Jcarbonell04/RGB-Reader/_datasheets/README.md

# Relevant Datasheets

Use this folder to store all relevant datasheets for devices used in your project.
