Jcarbonell04/RGB-Reader/pcb/README.md

# PCB Design

All design files for your PCB version of your project go here.
