Jcarbonell04/RGB-Reader/pcb/Choosing PWM Channels.png

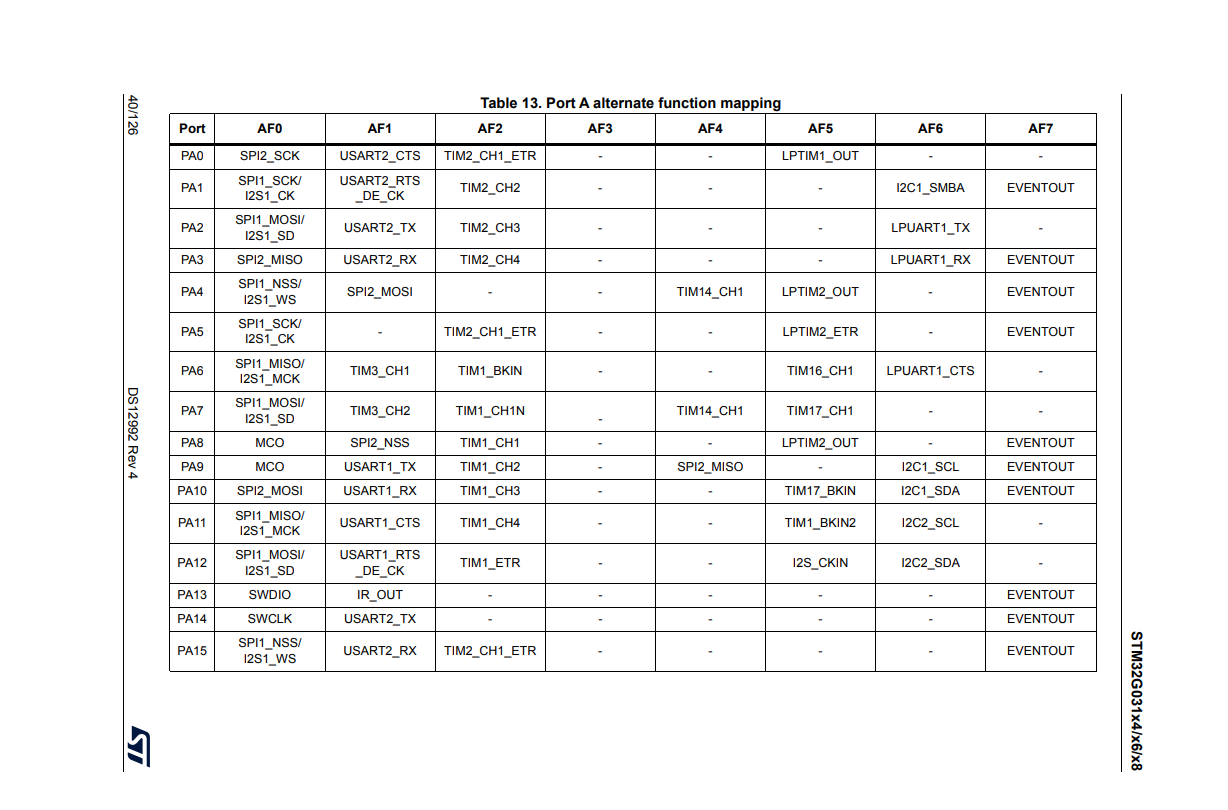
pcb/Choosing PWM Channels.png
