Jcarbonell04/RGB-Reader/pcb/Kicad lib/CLMVC-FKA-CLBDGL7LBB79353/CLMVC-FKA-CLBDGL7LBB79353.step

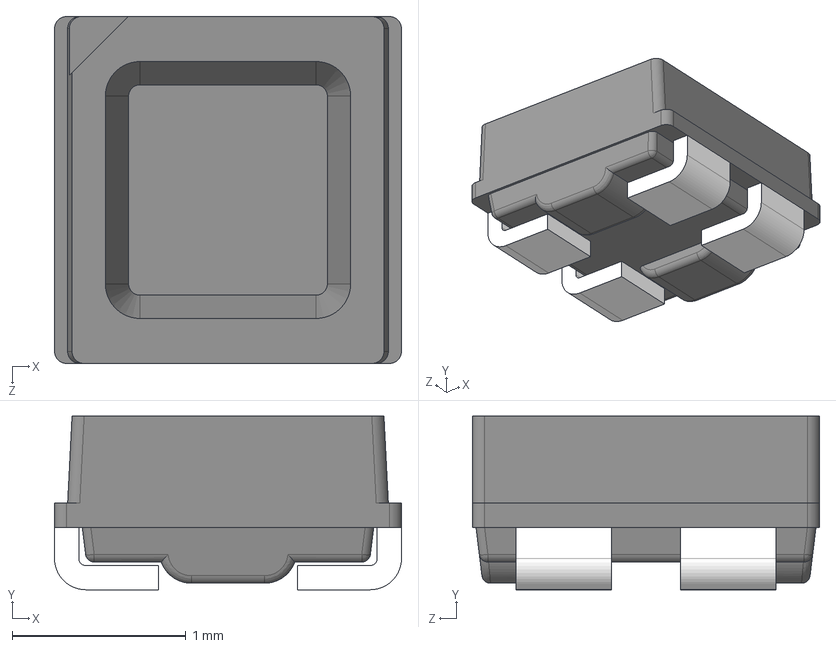
[picture p3: CAD file, 2025-10-31]
pcb/Kicad lib/CLMVC-FKA-CLBDGL7LBB79353/CLMVC-FKA-CLBDGL7LBB79353.step
2.00 x 1.00 x 2.00 mm
