Jcarbonell04/RGB-Reader/pcb/pcb_schematic/Kicad lib/LD1117S33TR/LD1117S33TR.step

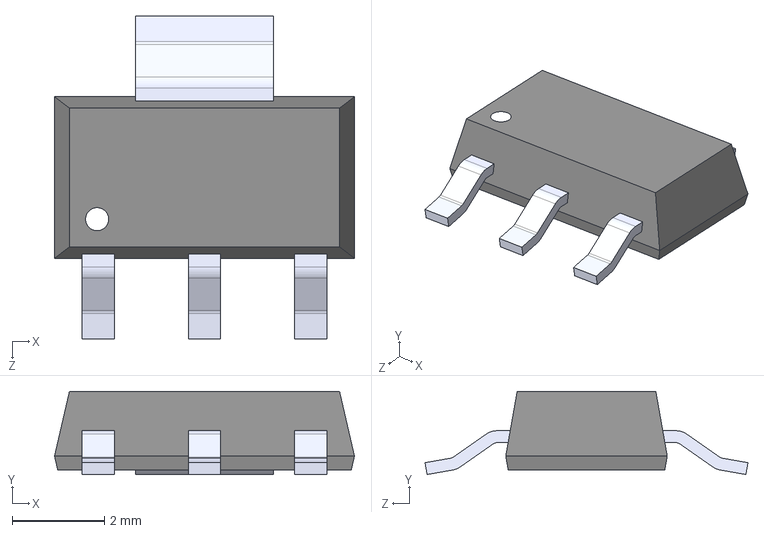
[picture p4: CAD file, 2025-11-05]
pcb/pcb_schematic/Kicad lib/LD1117S33TR/LD1117S33TR.step
6.50 x 1.80 x 7.00 mm
