Jcarbonell04/RGB-Reader/pcb/pcb_schematic_V1.pdf

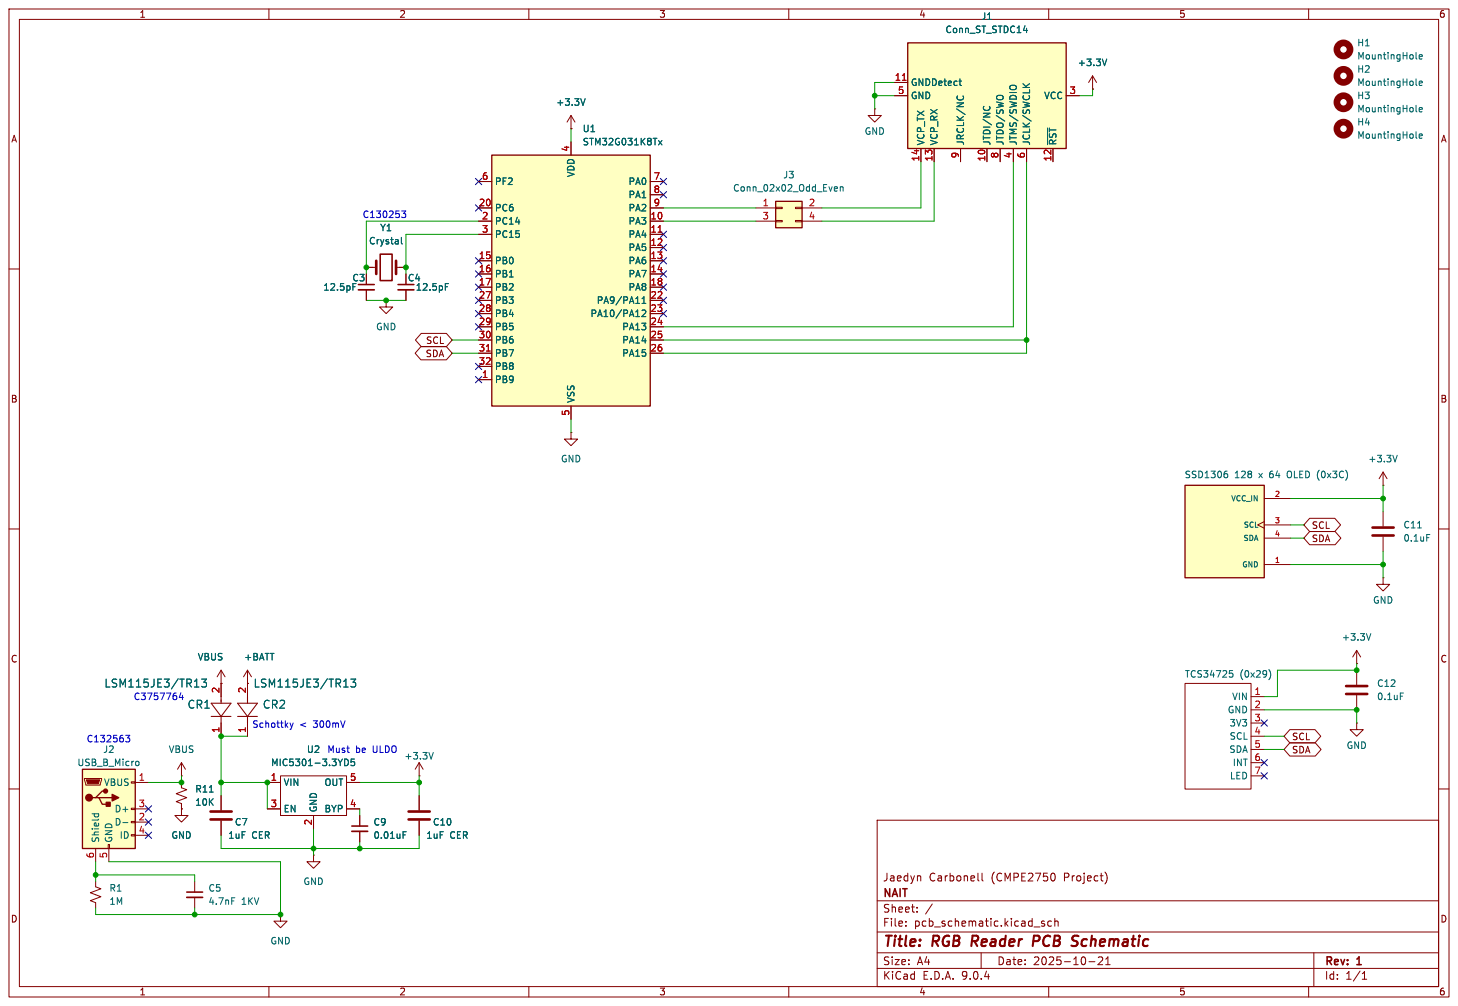
[picture p7: page 1]

8 JTDI/NC 10 JRCLK/NC

Id: 1/1 Title: RGB Reader PCB Schematic
