Jcarbonell04/RGB-Reader/pcb/pcb_schematic_V2.pdf

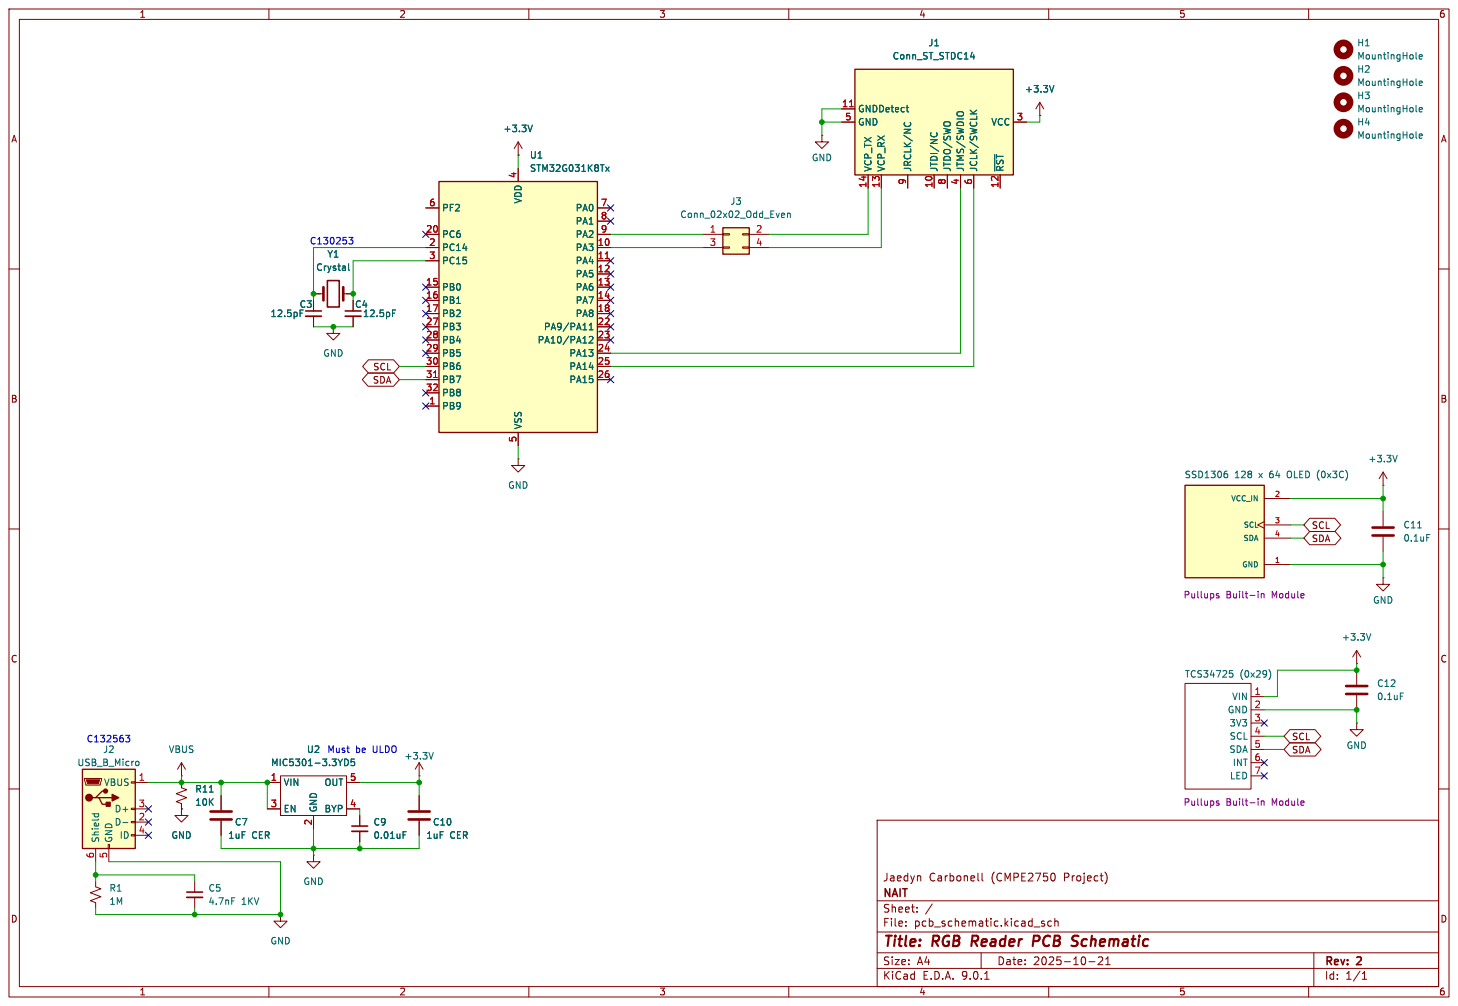
[picture p8: page 1]

5 PA0 7 PA1 8 PA2 9 PA3 10 PA4 11 PA5 12 PA6 13 PA7 14 PA8 18 PA9/PA11 22 PA10/PA12 23 PA13 24 PA14 25 PA15 26 U1STM32G031K8Tx H4 MountingHole GNDDetect 11 VCC 3 GND 5 ~{RST} 12 JCLK/SWCLK

8 JTDI/NC 10 JRCLK/NC

Id: 1/1 Title: RGB Reader PCB Schematic
