Jcarbonell04/RGB-Reader/breadboard/bread_schematic/bread_schematic_V1.pdf

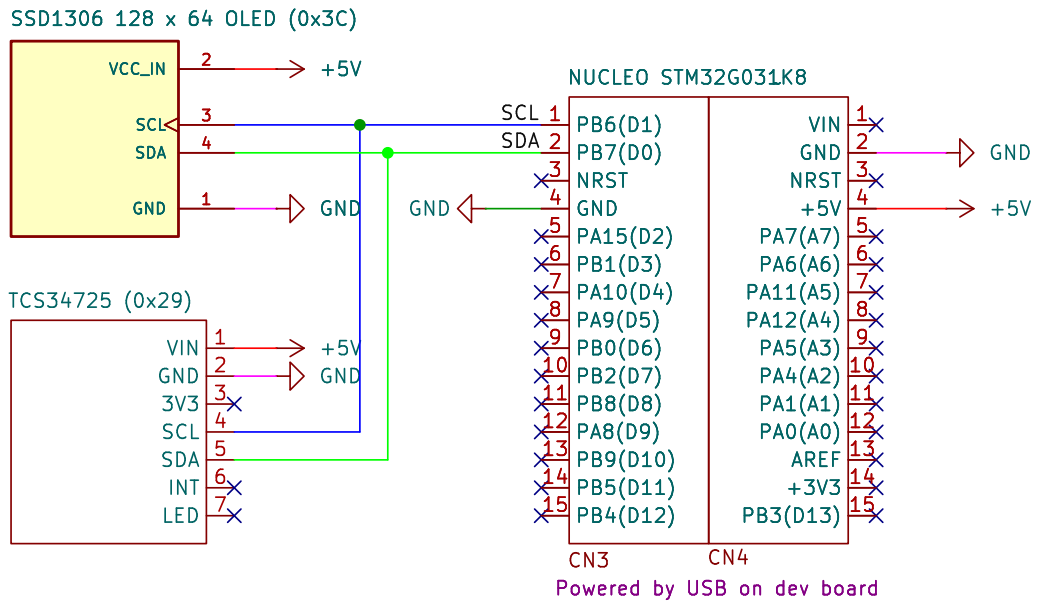
[picture p9: page 1]

Id: 1/1 Title: RGB Reader Breadboard Design (Proof of Life) File: bread_schematic.kicad_sch Sheet: / NAIT
