Jcarbonell04/RGB-Reader/pcb/Adafruit Schematic/TCS34725_schematic/TCS34725_schematic.kicad_pcb

## KiCad design pcb/Adafruit Schematic/TCS34725_schematic/TCS34725_schematic.kicad_pcb (2025-10-24)

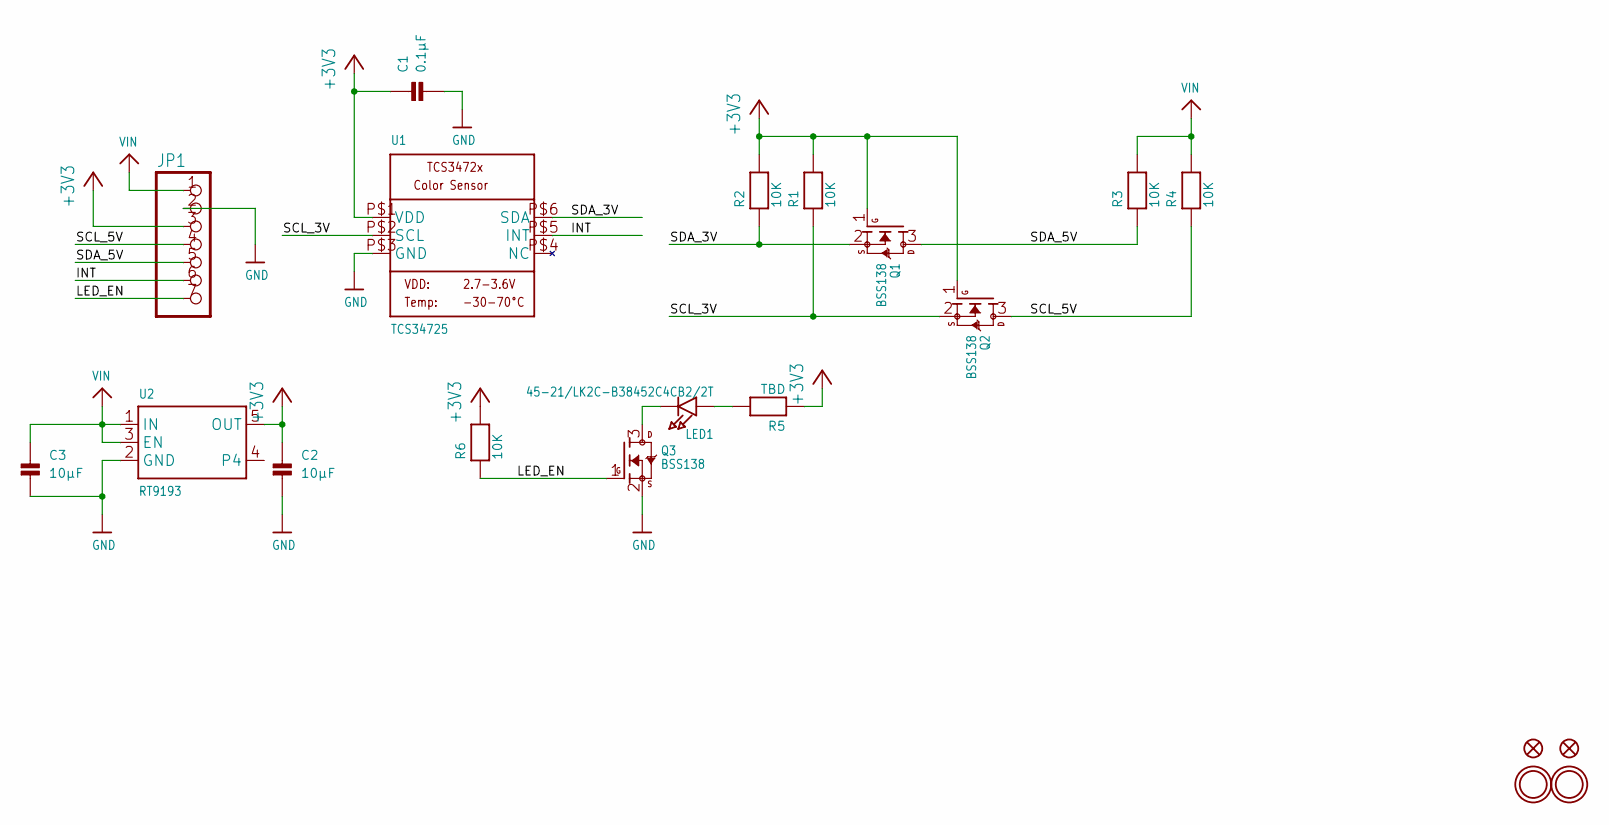
[picture p11: schematic TCS34725_schematic.kicad_sch]

Parts:
C1: 0.1µF; _0805
C2, C3: 10µF; _0805
FID1, FID2: FIDUCIAL""; FIDUCIAL_1MM
JP1: HEADER-1X770MIL; 1X07_ROUND_70
LED1: 45-21/LK2C-B38452C4CB2/2T; EVERLIGHT_45-21
Q1, Q2, Q3: BSS138; SOT23-WIDE
R1, R2, R3, R4, R6: 10K; _0805
R5: TBD; _0805
U1: TCS34725; TCS3472_FN6
U2: RT9193; SOT23-5
U$8, U$14: MOUNTINGHOLE2.5; MOUNTINGHOLE_2.5_PLATED

Connections:
+3V3: C1.1, C2.1, JP1.3, Q1.1 (G), Q2.1 (G), R1.2, R2.2, R5.1, R6.2, U1.P$1 (VDD), U2.5 (OUT)
GND: C1.2, C2.2, C3.2, JP1.2, Q3.2 (S), U1.P$3 (GND), U2.2 (GND)
INT: JP1.6, U1.P$5 (INT)
LED_EN: JP1.7, Q3.1 (G), R6.1
unnamed: LED1.K (C), Q3.3 (D)
unnamed: LED1.A, R5.2
SCL_3V: Q2.2 (S), R1.1, U1.P$2 (SCL)
SCL_5V: JP1.4, Q2.3 (D), R4.1
SDA_3V: Q1.2 (S), R2.1, U1.P$6 (SDA)
SDA_5V: JP1.5, Q1.3 (D), R3.1
VIN: C3.1, JP1.1, R3.2, R4.2, U2.1 (IN), U2.3 (EN)

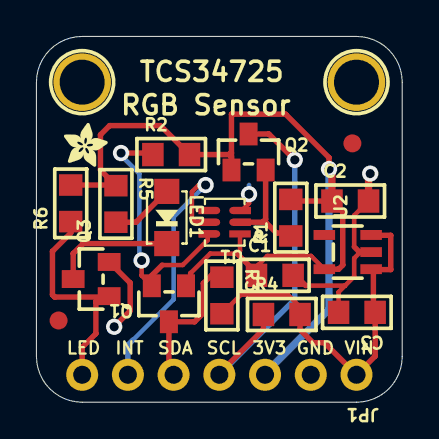
[picture p12: board TCS34725_schematic.kicad_pcb from above]

Board: 2 copper layers, 20.3 x 20.3 mm, 22 parts (1 on the bottom side), 11 nets.

Other parts of the board:
U$2: ADAFRUIT_2.5MM
U$18: ADAFRUIT_5MM
