Jcarbonell04/RGB-Reader/pcb/pcb_schematic/pcb_schematic.kicad_pcb

## KiCad design pcb/pcb_schematic/pcb_schematic.kicad_pcb (2025-11-09)

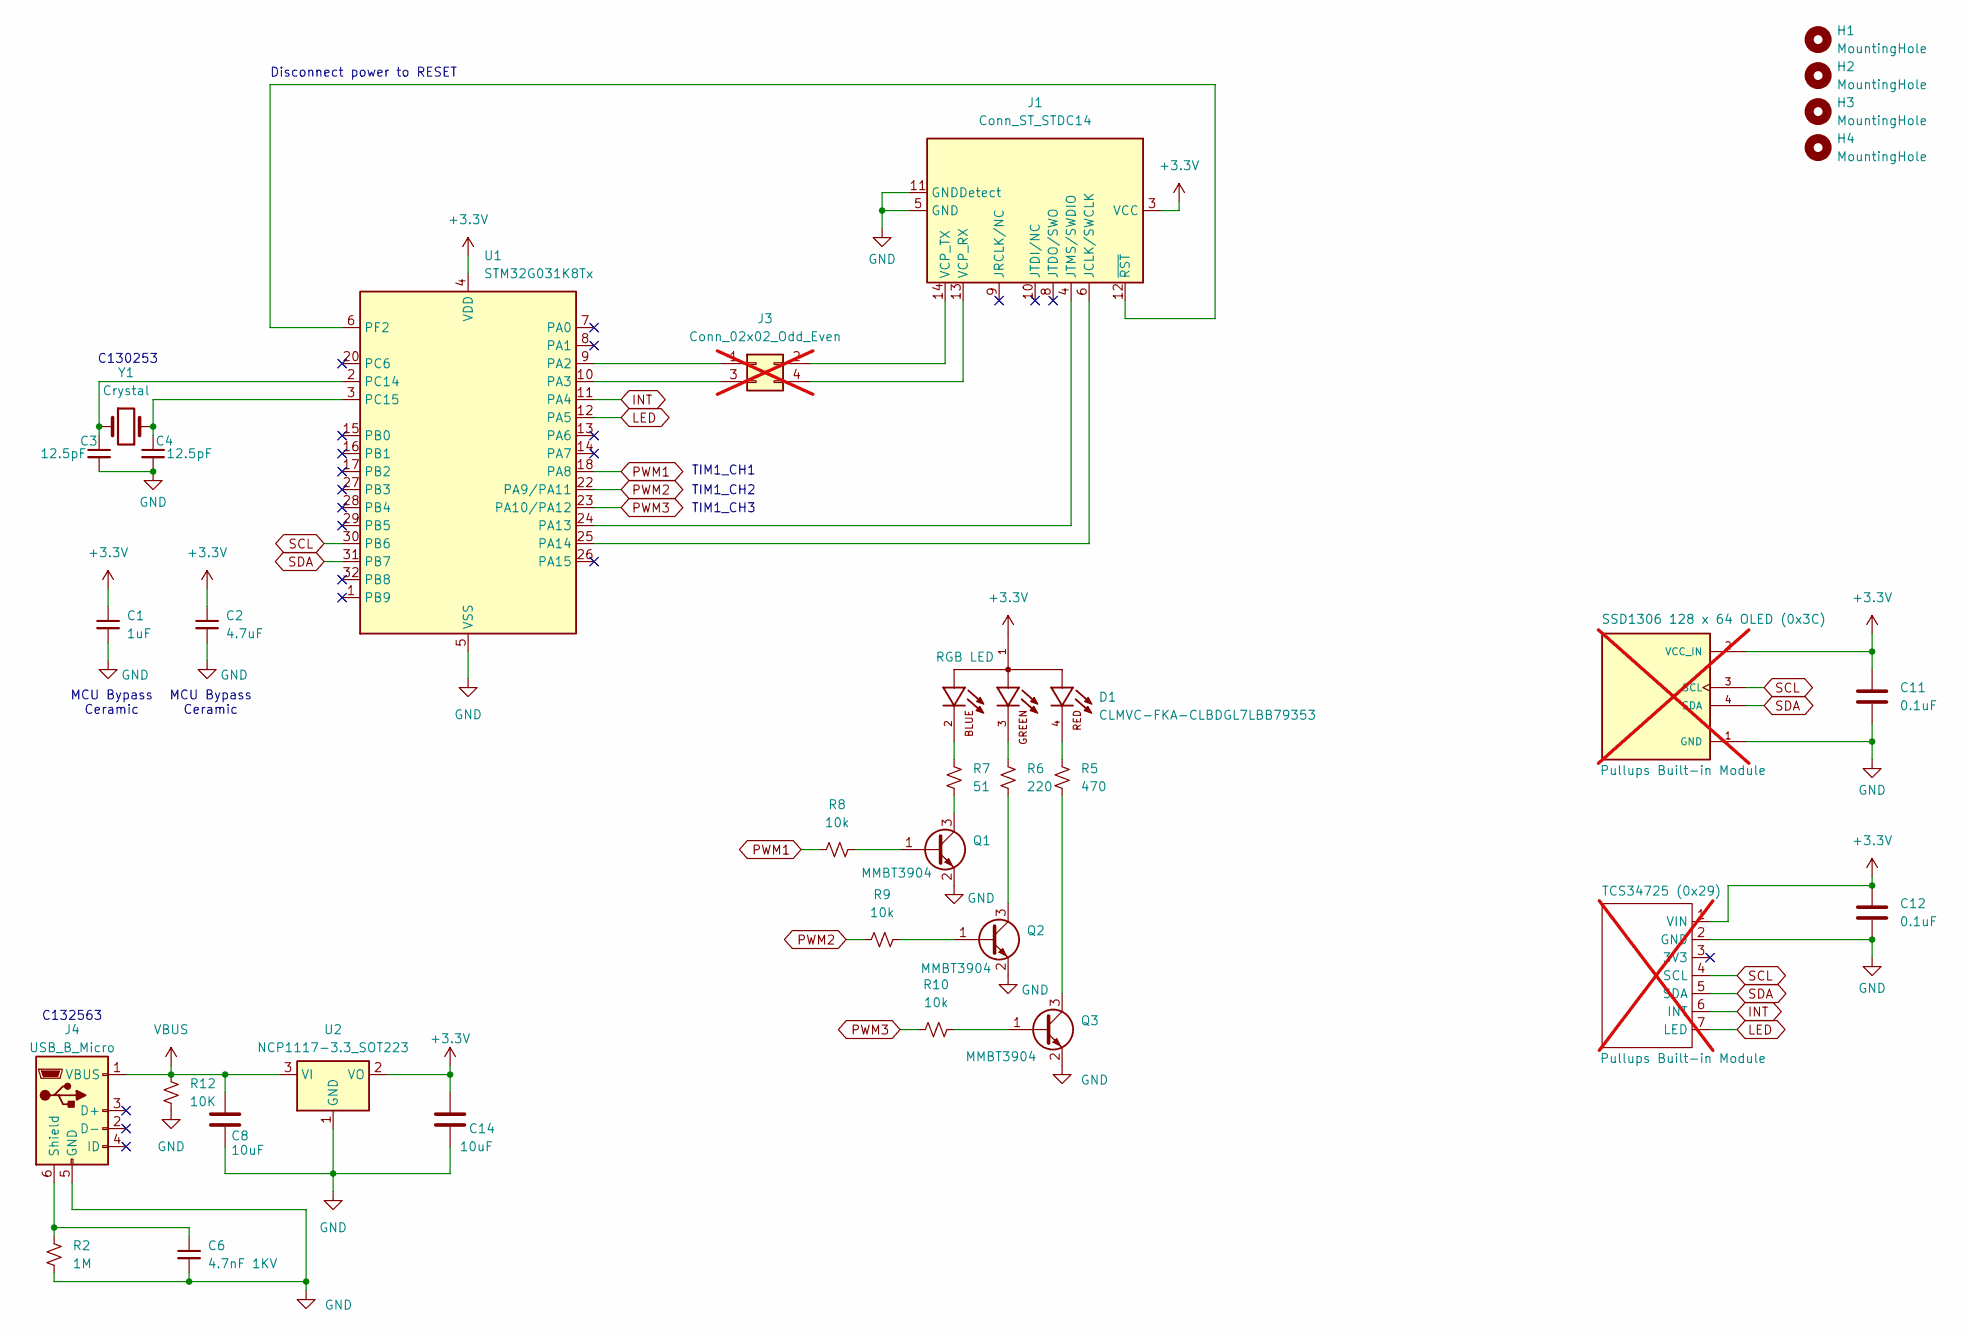
[picture p13: schematic pcb_schematic.kicad_sch, RGB Reader PCB Schematic]

Parts:
C1: 1uF; C_0805_2012Metric
C2: 4.7uF; C_0805_2012Metric
C3, C4: 12.5pF; C_0805_2012Metric
C6: 4.7nF 1KV; C_0805_2012Metric
C8, C14: 10uF; C_0805_2012Metric
C11, C12: 0.1uF; C_0805_2012Metric
D1: CLMVC-FKA-CLBDGL7LBB79353; LED_CLMVC-FKA-CLBDGL7LBB79353; PARTREV 14
H1, H2, H3, H4: MountingHole; MountingHole_3.2mm_M3
J1: Conn_ST_STDC14; PinHeader_2x07_P1.27mm_Vertical_SMD
J3: Conn_02x02_Odd_Even; PinHeader_2x02_P2.54mm_Vertical; not fitted
J4: USB_B_Micro; USB_Micro-B_Amphenol_10118194_Horizontal
Q1, Q2, Q3: MMBT3904; SOT-23
R2: 1M; R_0805_2012Metric
R5: 470; R_0805_2012Metric
R6: 220; R_0805_2012Metric
R7: 51; R_0805_2012Metric
R8, R9, R10: 10k; R_0805_2012Metric
R12: 10K; R_0805_2012Metric
U1: STM32G031K8Tx; LQFP-32_7x7mm_P0.8mm
U2: NCP1117-3.3_SOT223; SOT-223-3_TabPin2
U4: SSD1306 128 x 64 OLED (0x3C); 128x64OLED; PARTREV 2018-09-10; not fitted
U5: TCS34725 (0x29); TCS34725; not fitted
Y1: Crystal; Crystal_SMD_3215-2Pin_3.2x1.5mm

Connections:
+3.3V: C1.1, C2.1, C11.1, C12.1, C14.2, D1.1, J1.3 (VCC), U1.4 (VDD), U2.2 (VO), U4.2 (VCC_IN), U5.1 (VIN)
GND: C1.2, C2.2, C3.2, C4.2, C6.2, C8.1, C11.2, C12.2, C14.1, J1.5 (GND), J1.7 (GND), J1.11 (GNDDetect), J4.5 (GND), Q1.2 (E), Q2.2 (E), Q3.2 (E), R2.2, R12.1, U1.5 (VSS), U2.1 (GND), U4.1 (GND), U5.2 (GND)
INT: U1.11 (PA4), U5.6 (INT)
LED: U1.12 (PA5), U5.7 (LED)
unnamed: D1.2, R7.1
unnamed: D1.3, R6.1
unnamed: D1.4, R5.1
unnamed: J1.6 (JCLK/SWCLK), U1.25 (PA14)
unnamed: J1.4 (JTMS/SWDIO), U1.24 (PA13)
unnamed: J1.13 (VCP_RX), J3.4
unnamed: J1.14 (VCP_TX), J3.2
unnamed: J1.12 (~RST), U1.6 (PF2)
unnamed: J3.1, U1.9 (PA2)
unnamed: J3.3, U1.10 (PA3)
unnamed: C6.1, J4.6 (Shield), R2.1
unnamed: Q1.1 (B), R8.2
unnamed: Q1.3 (C), R7.2
unnamed: Q2.1 (B), R9.2
unnamed: Q2.3 (C), R6.2
unnamed: Q3.1 (B), R10.2
unnamed: Q3.3 (C), R5.2
unnamed: C3.1, U1.2 (PC14), Y1.1
unnamed: C4.1, U1.3 (PC15), Y1.2
PWM1: R8.1, U1.18 (PA8)
PWM2: R9.1, U1.22 (PA9/PA11)
PWM3: R10.1, U1.23 (PA10/PA12)
SCL: U1.30 (PB6), U4.3 (SCL), U5.4 (SCL)
SDA: U1.31 (PB7), U4.4 (SDA), U5.5 (SDA)
VBUS: C8.2, J4.1 (VBUS), R12.2, U2.3 (VI)

Notes on the sheet:
TIM1_CH3
TIM1_CH2
TIM1_CH1
C132563
MCU Bypass Ceramic
Disconnect power to RESET
C130253

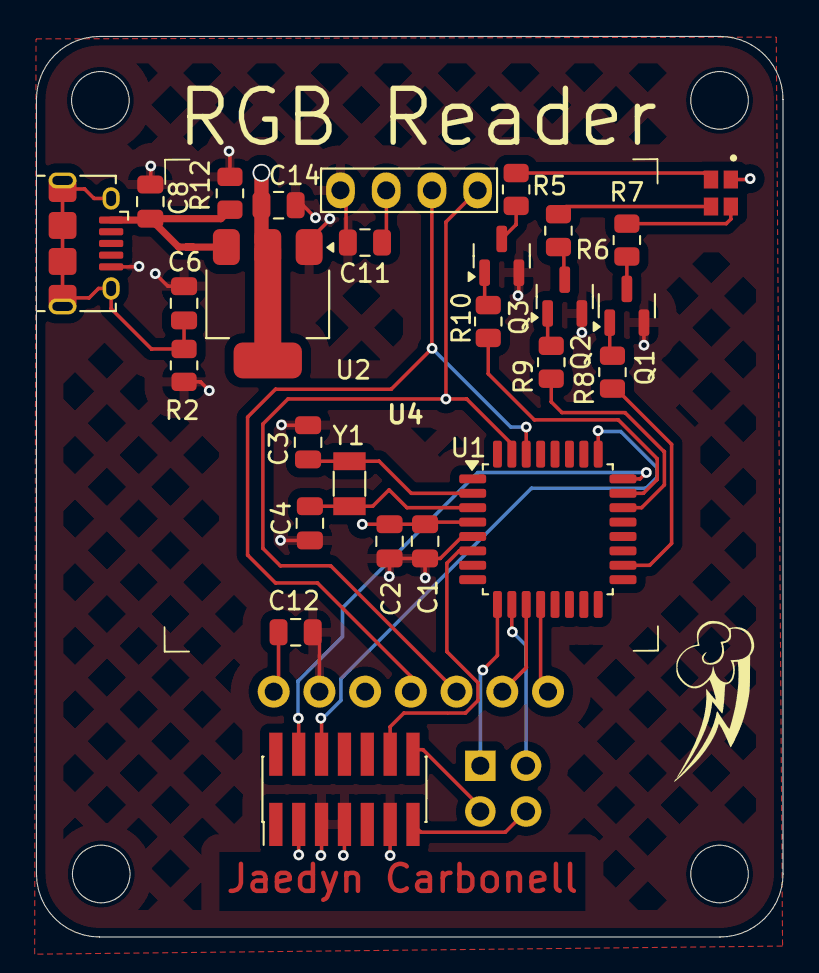
[picture p14: board pcb_schematic.kicad_pcb from above]

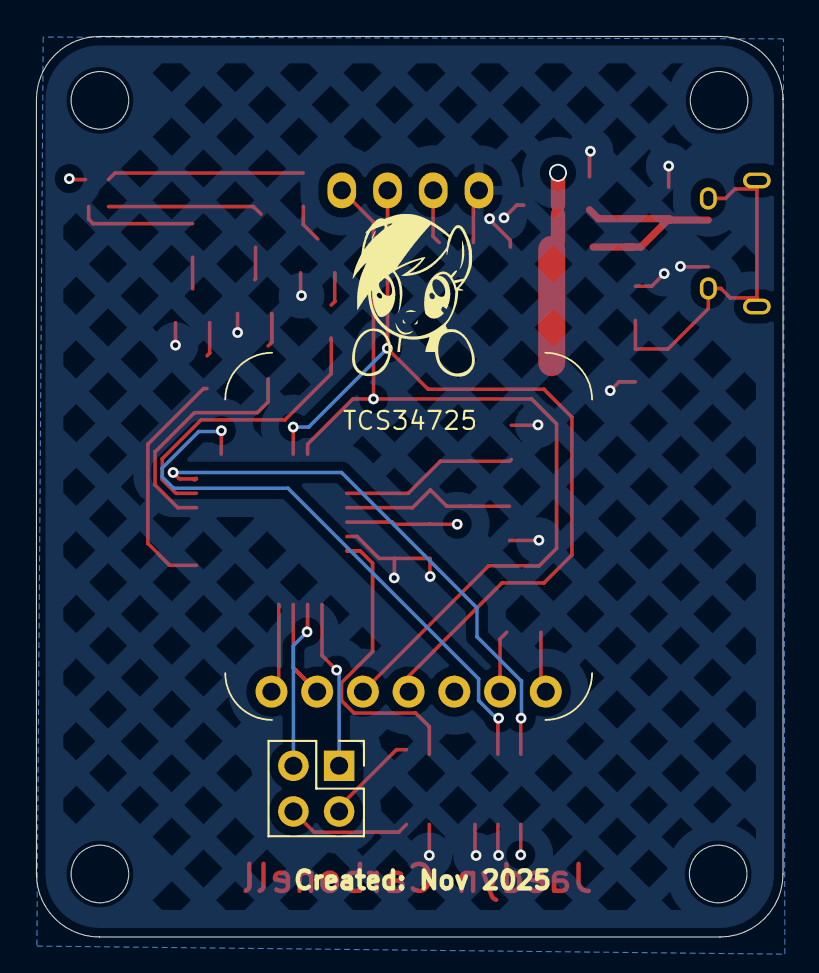
[picture p15: board pcb_schematic.kicad_pcb from below]

Board: 4 copper layers, 41.5 x 50.0 mm, 33 parts (2 on the bottom side), 29 nets.
