Jcarbonell04/RGB-Reader/breadboard/bread_schematic/bread_schematic.kicad_sch

## KiCad design breadboard/bread_schematic/bread_schematic.kicad_sch (2025-11-04)

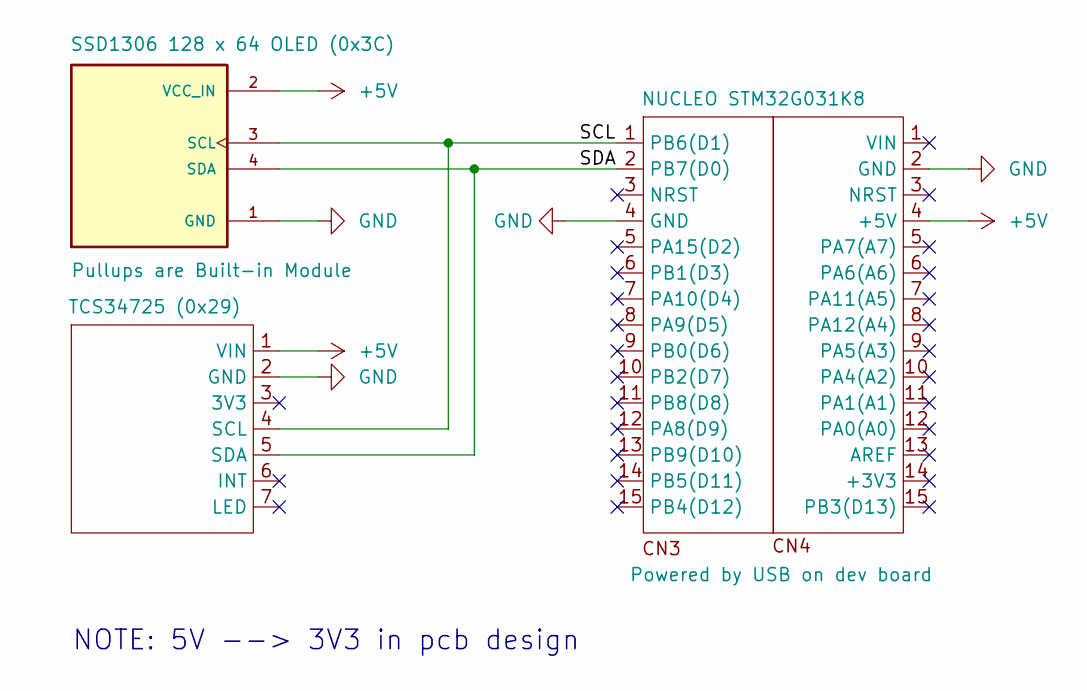
[picture p16: schematic bread_schematic.kicad_sch]

Parts:
M1: NUCLEO STM32G031K8
M2: (no value)
U1: SSD1306 128 x 64 OLED (0x3C); MODULE_DM-OLED096-636; PARTREV 2018-09-10
U2: TCS34725 (0x29)

Connections:
+5V: M2.4 (+5V), U1.2 (VCC_IN), U2.1 (VIN)
GND: M1.4 (GND), M2.2 (GND), U1.1 (GND), U2.2 (GND)
SCL: M1.1 (PB6(D1)), U1.3 (SCL), U2.4 (SCL)
SDA: M1.2 (PB7(D0)), U1.4 (SDA), U2.5 (SDA)

Notes on the sheet:
NOTE: 5V --> 3V3 in pcb design
