Jcarbonell04/RGB-Reader/(commit log)

2025-09-24 Added Instructors Content
    [0201.STEP, C0402.STEP, C0805_2012D.STEP, DFN6-EPAD_3X3_P095.STEP, KSS221GLFS.stp, LED_0603_GREEN.STEP, LED_0603_RED_H0P4.STEP, LQFP32_7x7_p080.STEP]
2025-10-08 soldered lol
2025-10-13 omg sensor working?
2025-10-22 finished breadboard schematic
    [bread_schematic.kicad_sch]
2025-10-22 i lowkey dont know what im doing
    [bread_schematic.kicad_sch, pcb_schematic.kicad_pcb, pcb_schematic.kicad_sch]
2025-10-22 oct 22
    [TCS34725_schematic.kicad_pcb, TCS34725_schematic.kicad_sch, bread_schematic.kicad_sch, pcb_schematic.kicad_sch]
2025-10-29 v4 now?
    [pcb_schematic.kicad_sch]
2025-10-31 almost checkoff
    [CLMVC-FKA-CLBDGL7LBB79353.step, pcb_schematic.kicad_pcb, pcb_schematic.kicad_sch]
2025-11-04 Changed after recieving feedback
    [bread_schematic.kicad_sch]
2025-11-04 PWM on Timer 1 Pins
    [pcb_schematic.kicad_sch]
2025-11-05 the schmatic keeps chaning i wanna cry
    [CLMVC-FKA-CLBDGL7LBB79353.step, LD1117S33TR.step, pcb_schematic.kicad_pcb, pcb_schematic.kicad_sch]
2025-11-05 Components are laid out
    [pcb_schematic.kicad_pcb]
2025-11-06 before i change many thing
    [pcb_schematic.kicad_pcb]
2025-11-06 moved rbg led
    [pcb_schematic.kicad_pcb]
2025-11-06 Created pcb desgin, need to rid of all warning
    [pcb_schematic.kicad_pcb, pcb_schematic.kicad_sch]
2025-11-07 fixerd some warnings with the silkscreen
    [pcb_schematic.kicad_pcb]
2025-11-07 Fixed according to feedback
    Schematic -> looks like the current limiting resistors for the read and blue LEDs are reversed.
    Bypass caps for the MCU are drawn really weird!
    Looks like you moved the XTAL and now you have two redundant wires.
    PCB -> Identification is in the copper layer, not the silk layer.
    C12 does not need vias, the through-hole header serves as vias.
    You've got a split on the SDA line of the MCU - try to route from a via, or another pad if you can.
    For the power supply, you've not used the filter caps correctly. Go from the USB connector to C8, then to regulator pin 3 (not from reg pin3 to the usb). You can put a fat track between the two pin 2s. You can add a new via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
    [pcb_schematic.kicad_pcb, pcb_schematic.kicad_sch]
2025-11-08 via error
    [pcb_schematic.kicad_pcb]
2025-11-08 via warning
    [pcb_schematic.kicad_pcb]
2025-11-08 added image lol
    [pcb_schematic.kicad_pcb]
2025-11-09 ready to order :D
    [bom.csv, designators.csv, pcb_schematic.kicad_pcb, positions.csv]
2026-02-04 Add unpopulated PCB photos to README
    Added images of the unpopulated PCB to the README.
2026-02-04 Modify PCB photo entries in README
    Updated image tags for unpopulated PCB photos in README.
